kuellenberg/NRF24/README.md

# NRF24

Wireless temperature and humidity transmitter using the nRF24L01+

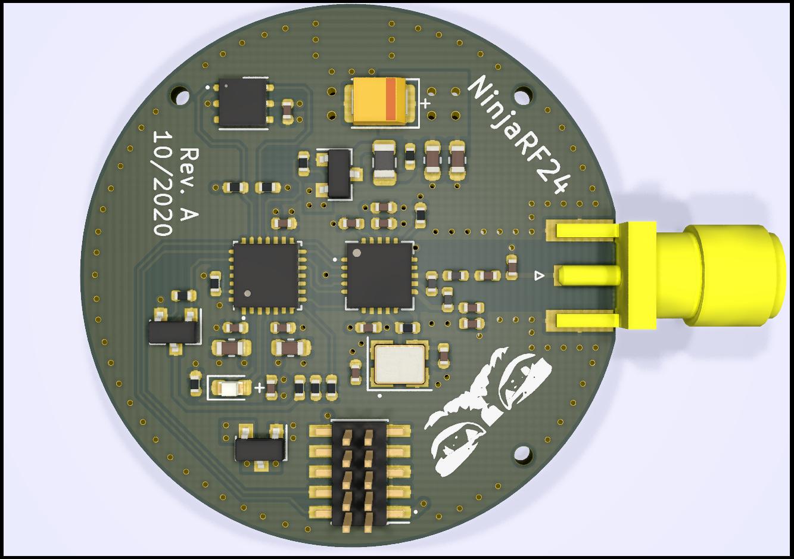
[picture p1: NRF24.jpg]
