kuellenberg/NRF24/NRF24-Schematic.pdf

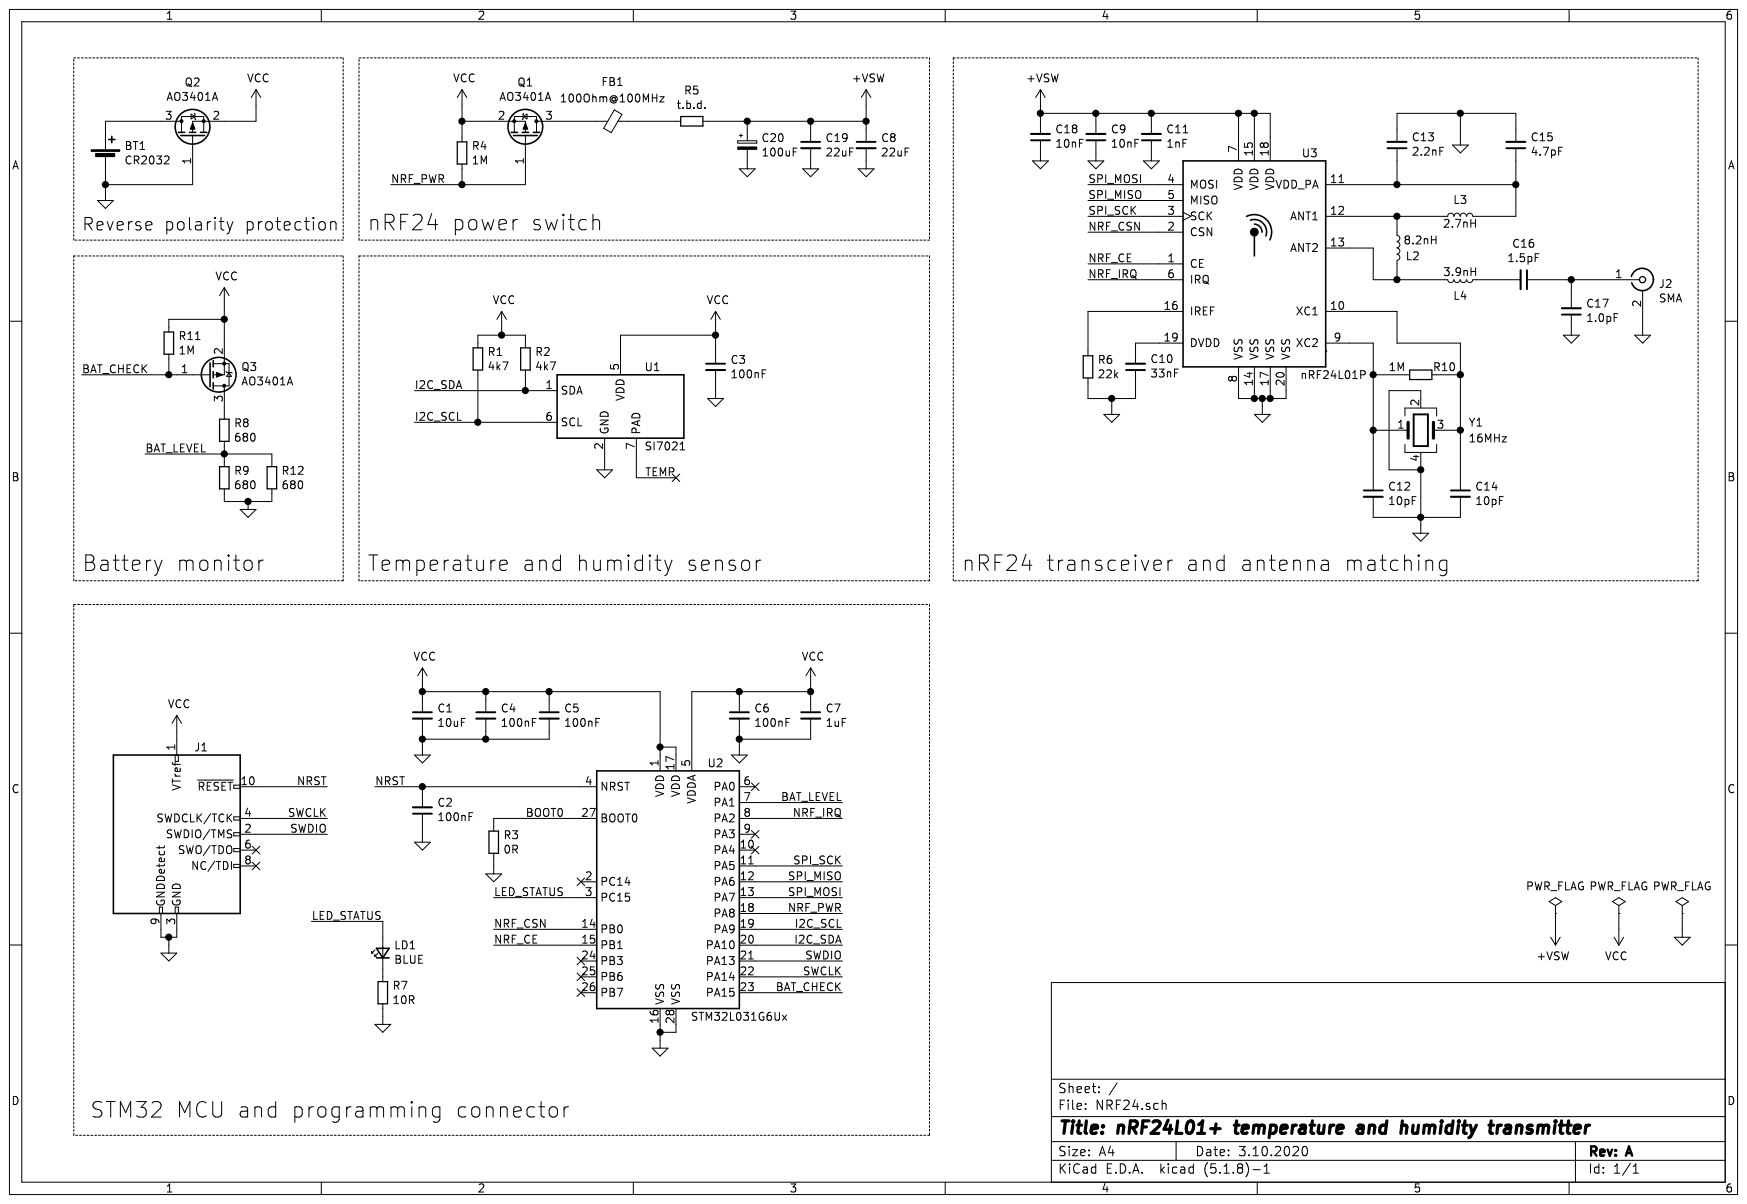
[picture p2: page 1]
