kuellenberg/NRF24/spice/capcharge.asc

C1: cap; 22µ
M2: nmos; AO6408
M3: pmos; BSS84
R1: res; 1k
R2: res; 200
V1: voltage; 3
V2: voltage; PULSE(3 0 1 1m 1m 5 10 1)
V3: voltage; PULSE(0 3 10 1u 1u 1m 10 1)
Named nets: 0
.tran 30 startup
