kuellenberg/NRF24/NRF24.kicad_pcb

## KiCad design NRF24.kicad_pcb (2020-12-05)

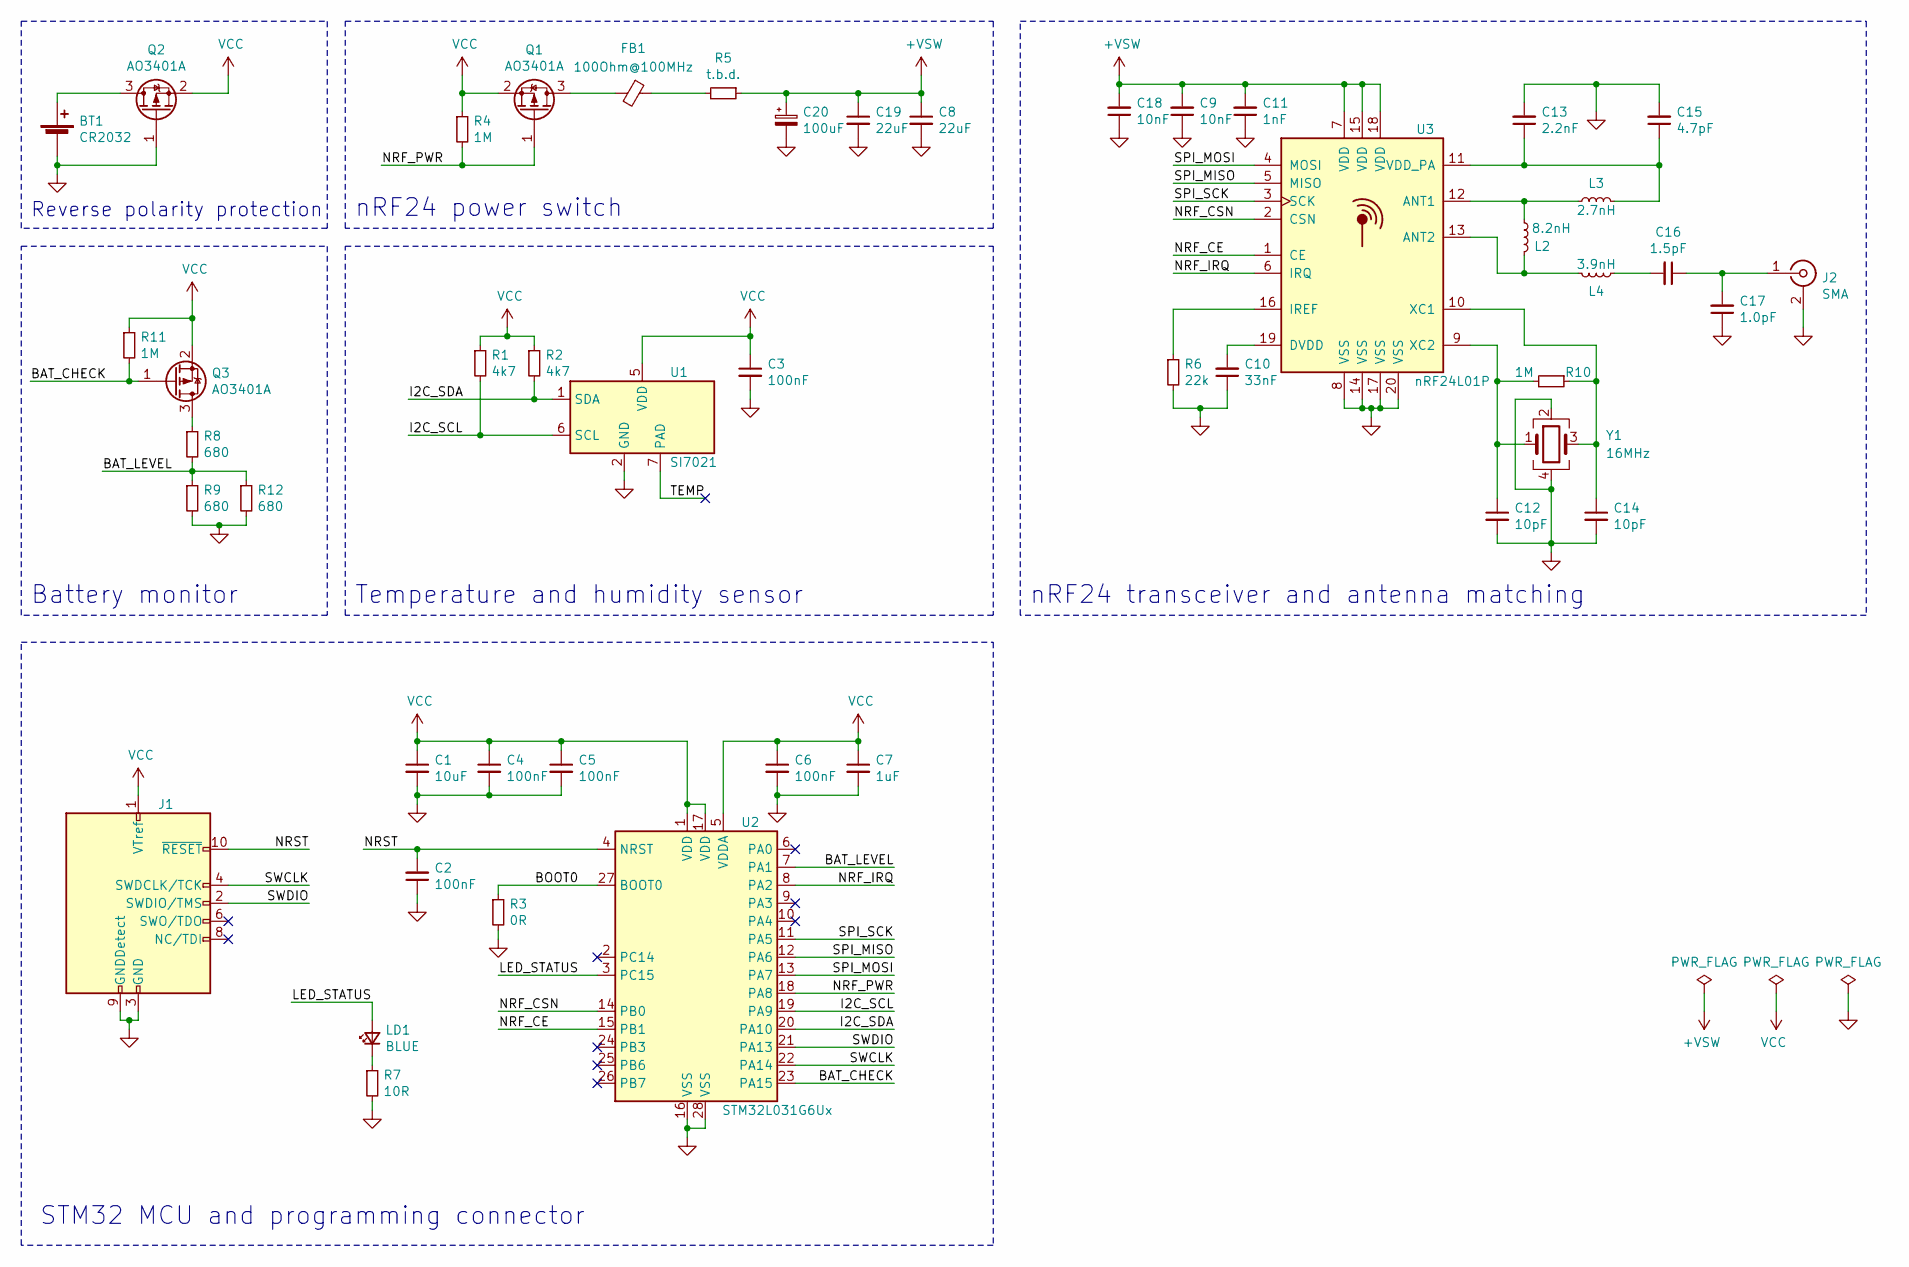
[picture p3: schematic NRF24.sch]

Parts:
BT1: CR2032; BatteryHolder_Keystone_1060_1x2032; Mouser 534-1060TR
C1: 10uF; C_0603_1608Metric; LCSC C19702
C2, C3, C4, C5, C6: 100nF; C_0402_1005Metric; LCSC C1525
C7: 1uF; C_0603_1608Metric; LCSC C15849
C8, C19: 22uF; C_0603_1608Metric; LCSC C59461
C9, C18: 10nF; C_0402_1005Metric; LCSC C15195
C10: 33nF; C_0402_1005Metric; LCSC C1585
C11: 1nF; C_0402_1005Metric; LCSC C1523
C12, C14: 10pF; C_0402_1005Metric; LCSC C32949
C13: 2.2nF; C_0402_1005Metric; LCSC C1531
C15: 4.7pF; C_0402_1005Metric; LCSC C1569
C16: 1.5pF; C_0402_1005Metric; LCSC C1552
C17: 1.0pF; C_0402_1005Metric; LCSC C1550
C20: 100uF; CP_EIA-3528-15_AVX-H; LCSC C16133
FB1: 100Ohm@100MHz; L_0805_2012Metric; LCSC C1015
J1: Conn_ARM_JTAG_SWD_10; PinHeader_2x05_P1.27mm_Vertical_SMD; Mouser 855-M50-3610542R
J2: SMA; SMA_Samtec_SMA-J-P-H-ST-EM1_EdgeMount; Mouser 200-SMAJPHSTEM1
L2: 8.2nH; L_0402_1005Metric; LCSC C16208
L3: 2.7nH; L_0402_1005Metric; LCSC C27123
L4: 3.9nH; L_0402_1005Metric; LCSC C14033
LD1: BLUE; LED_0603_1608Metric; LCSC LED_0603
Q1, Q2, Q3: AO3401A; SOT-23; LCSC C15127
R1, R2: 4k7; R_0402_1005Metric; LCSC C25900
R3: 0R; R_0402_1005Metric; LCSC C17168
R4, R10, R11: 1M; R_0402_1005Metric; LCSC C26083
R5: t.b.d.; R_0402_1005Metric; LCSC C11702
R6: 22k; R_0402_1005Metric; LCSC C25768
R7: 10R; R_0402_1005Metric; LCSC C25077
R8, R9, R12: 680; R_0402_1005Metric; LCSC C25130
U1: SI7021; DFN-6-1EP_3x3mm_P1mm_EP1.5x2.4mm; LCSC C132603
U2: STM32L031G6Ux; QFN-28_4x4mm_P0.5mm; LCSC C96514
U3: nRF24L01P; QFN-20-1EP_4x4mm_P0.5mm_EP2.5x2.5mm; LCSC C8791
Y1: 16MHz; Crystal_SMD_3225-4Pin_3.2x2.5mm; LCSC C13738

Connections:
+VSW: C8.1, C9.2, C11.2, C18.2, C19.1, C20.1, R5.1, U3.7 (VDD), U3.15 (VDD), U3.18 (VDD)
/BAT_CHECK: Q3.1 (G), R11.2, U2.23 (PA15)
/BAT_LEVEL: R8.2, R9.1, R12.1, U2.7 (PA1)
/BOOT0: R3.1, U2.27 (BOOT0)
/I2C_SCL: R1.2, U1.6 (SCL), U2.19 (PA9)
/I2C_SDA: R2.2, U1.1 (SDA), U2.20 (PA10)
/LED_STATUS: LD1.2 (A), U2.3 (PC15)
/NRF_CE: U2.15 (PB1), U3.1 (CE)
/NRF_CSN: U2.14 (PB0), U3.2 (CSN)
/NRF_IRQ: U2.8 (PA2), U3.6 (IRQ)
/NRF_PWR: Q1.1 (G), R4.2, U2.18 (PA8)
/NRST: C2.2, J1.10 (~RESET~), U2.4 (NRST)
/SPI_MISO: U2.12 (PA6), U3.5 (MISO)
/SPI_MOSI: U2.13 (PA7), U3.4 (MOSI)
/SPI_SCK: U2.11 (PA5), U3.3 (SCK)
/SWCLK: J1.4 (SWDCLK/TCK), U2.22 (PA14)
/SWDIO: J1.2 (SWDIO/TMS), U2.21 (PA13)
/TEMP: U1.7 (PAD)
GND: BT1.2 (-), C1.2, C2.1, C3.2, C4.2, C5.2, C6.2, C7.2, C8.2, C9.1, C10.1, C11.1, C12.2, C13.2, C14.2, C15.2, C17.1, C18.1, C19.2, C20.2, J1.3 (GND), J1.5 (GND), J1.9 (GNDDetect), J2.2 (Ext), Q2.1 (G), R3.2, R6.2, R7.2, R9.2, R12.2, U1.2 (GND), U2.16 (VSS), U2.28 (VSS), U3.8 (VSS), U3.14 (VSS), U3.17 (VSS), U3.20 (VSS), U3.21, Y1.2, Y1.4
unnamed: BT1.1 (+), Q2.3 (D)
unnamed: C10.2, U3.19 (DVDD)
unnamed: C12.1, R10.2, U3.9 (XC2), Y1.1
unnamed: C13.1, C15.1, L3.2, U3.11 (VDD_PA)
unnamed: C14.1, R10.1, U3.10 (XC1), Y1.3
unnamed: C16.1, C17.2, J2.1 (In)
unnamed: C16.2, L4.1
unnamed: FB1.1, R5.2
unnamed: FB1.2, Q1.3 (D)
unnamed: L2.1, L3.1, U3.12 (ANT1)
unnamed: L2.2, L4.2, U3.13 (ANT2)
unnamed: LD1.1 (K), R7.1
unnamed: Q3.3 (D), R8.1
unnamed: R6.1, U3.16 (IREF)
VCC: C1.1, C3.1, C4.1, C5.1, C6.1, C7.1, J1.1 (VTref), Q1.2 (S), Q2.2 (S), Q3.2 (S), R1.1, R2.1, R4.1, R11.1, U1.5 (VDD), U2.1 (VDD), U2.5 (VDDA), U2.17 (VDD)

Notes on the sheet:
nRF24 transceiver and antenna matching
Temperature and humidity sensor
Battery monitor
Reverse polarity protection
nRF24 power switch
STM32 MCU and programming connector

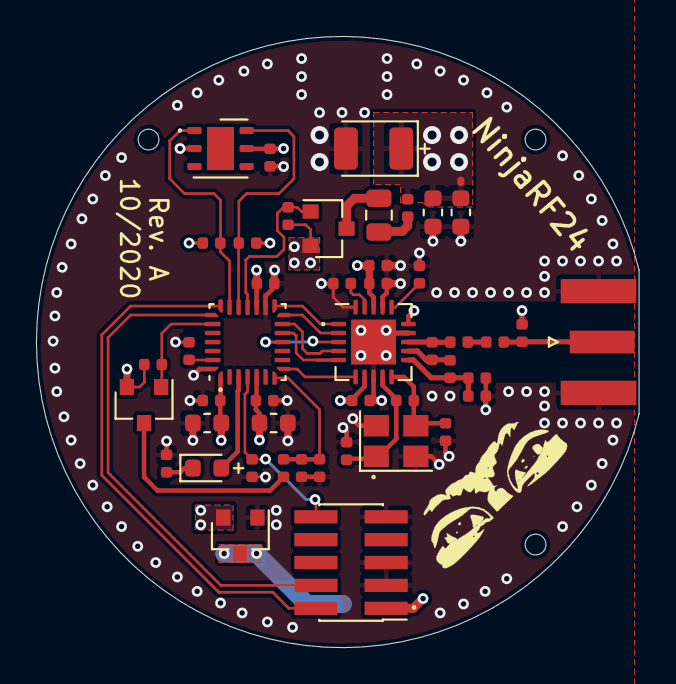
[picture p4: board NRF24.kicad_pcb from above]

Board: 4 copper layers, 33.5 x 34.0 mm, 47 parts (1 on the bottom side), 33 nets.
