kuellenberg/NRF24/Software/Core/Src/main.c

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
/* Includes ------------------------------------------------------------------*/
#include "main.h"

/* USER CODE BEGIN Includes */
#include "nrf24.h"
/* USER CODE END Includes */

ADC_HandleTypeDef hadc;

I2C_HandleTypeDef hi2c1;

RTC_HandleTypeDef hrtc;

SPI_HandleTypeDef hspi1;

void SystemClock_Config(void);
static void MX_GPIO_Init(void);
static void MX_I2C1_Init(void);
static void MX_ADC_Init(void);
static void MX_SPI1_Init(void);
static void MX_RTC_Init(void);
/**
  * @brief  The application entry point.
  * @retval int
  */
int main(void)
{
  /* USER CODE BEGIN 1 */
	uint8_t s,n;
	uint8_t count;
 	uint8_t buffer[10] = {0,0,0,0,0,0,0,0,0,0};
	uint8_t tx_addr[5] = {"1Node"};
	uint8_t pipe0[5] = {"2Node"};
  /* USER CODE END 1 */

  /* MCU Configuration--------------------------------------------------------*/

  /* Reset of all peripherals, Initializes the Flash interface and the Systick. */
  HAL_Init();

  /* Configure the system clock */
  SystemClock_Config();

  /* Initialize all configured peripherals */
  MX_GPIO_Init();
  MX_I2C1_Init();
  MX_ADC_Init();
  MX_SPI1_Init();
  MX_RTC_Init();
  /* USER CODE BEGIN 2 */

  HAL_GPIO_WritePin(BAT_CHECK_GPIO_Port, BAT_CHECK_Pin, GPIO_PIN_SET);

  nRF24_Init(&hspi1);
  s = nRF24_GetStatus();
  nRF24_FlushTX();
  nRF24_FlushRX();
  //nRF24_DisableAA(0);
  nRF24_SetRole(nRF24_ROLE_PTX);
  nRF24_SetRFChannel(115);
  nRF24_SetAddr(nRF24_PIPETX, tx_addr);
  nRF24_SetAddr(nRF24_PIPE0, pipe0);
  nRF24_SetDatarate(nRF24_DR_1Mbps);
  nRF24_SetCRC(nRF24_CRC_Disabled);
  nRF24_SetPowerMode(nRF24_MODE_PWR_UP);
  nRF24_SetARD(nRF24_ARD_1000);
  nRF24_SetARC(5);





  /* USER CODE END 2 */

  /* Infinite loop */
  /* USER CODE BEGIN WHILE */
  n = '0';
  while (1)
  {
    /* USER CODE END WHILE */

    /* USER CODE BEGIN 3 */

	  strcpy(buffer, "Test");
	  buffer[4] = n++;
	  if (n>'9') n = '0';
	  nRF24_WriteTXPayload(buffer, 5);
	  nRF24_CE_HIGH;
	  count = 10;
	  do {
		  s = nRF24_GetStatus();
		  if (s & nRF24_STATUS_TX_DS) {
			  s = s;
			  s = s;
			  break;
		  }
	  } while(--count);
	  //nRF24_WriteRegister(nRF24_REG_STATUS, 0b01110000);
	  nRF24_CE_LOW;
	  s = nRF24_GetStatus();
	  s = s;
	  s = nRF24_ReadRegister(nRF24_REG_OBSERVE_TX);
	  s = s;

	  HAL_Delay(500);
	  HAL_GPIO_TogglePin(LED_STATUS_GPIO_Port, LED_STATUS_Pin);
  }
  /* USER CODE END 3 */
}

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
