kuellenberg/NRF24/Software/Core/Inc/main.h

#define LED_STATUS_Pin GPIO_PIN_15
#define LED_STATUS_GPIO_Port GPIOC
#define BAT_LEVEL_Pin GPIO_PIN_1
#define BAT_LEVEL_GPIO_Port GPIOA
#define NRF_IRQ_Pin GPIO_PIN_2
#define NRF_IRQ_GPIO_Port GPIOA
#define NRF_CSN_Pin GPIO_PIN_0
#define NRF_CSN_GPIO_Port GPIOB
#define NRF_CE_Pin GPIO_PIN_1
#define NRF_CE_GPIO_Port GPIOB
#define NRF_PWR_Pin GPIO_PIN_8
#define NRF_PWR_GPIO_Port GPIOA
#define BAT_CHECK_Pin GPIO_PIN_15
#define BAT_CHECK_GPIO_Port GPIOA
