kuellenberg/NRF24/(commit log)

2020-09-27 Rough component placement
    [NRF24.sch]
2020-09-28 Minor changes
    [NRF24.kicad_pcb]
2020-10-18 Firmware Blinky Test
    [NRF24-B_Cu.gbr, NRF24-B_Mask.gbr, NRF24-B_Paste.gbr, NRF24-B_SilkS.gbr, NRF24-Edge_Cuts.gbr, NRF24-F_Cu.gbr, NRF24-F_Mask.gbr, NRF24-F_Paste.gbr]
2020-12-05 Updated schematic
    [NRF24.kicad_pcb, NRF24.sch]
